eSpark-Backup/adam-lucks-gate-security-system/README.md

# AdamLucks-GateSecuritySystem
 To design and develop a Gate Security System for ZUUL systems that employs Automatic License Plate Detection and Access Control
