eSpark-Backup/adam-lucks-gate-security-system/Documents/Dev-Files/Important Links.txt

https://codrinsideas.medium.com/diy-raspberry-pi-parking-system-with-platerecognizers-alpr-8e2254298917
