eSpark-Backup/adam-lucks-gate-security-system/Documents/Dev-Files/Important Info/Bring back the CAM.docx

STEPS TO CLEAR FAULT STATE OF GOOGLE FIREBASE

1. Type VNC Viewer on search bar in windows and hit Enter.
2. The following screen will popup.

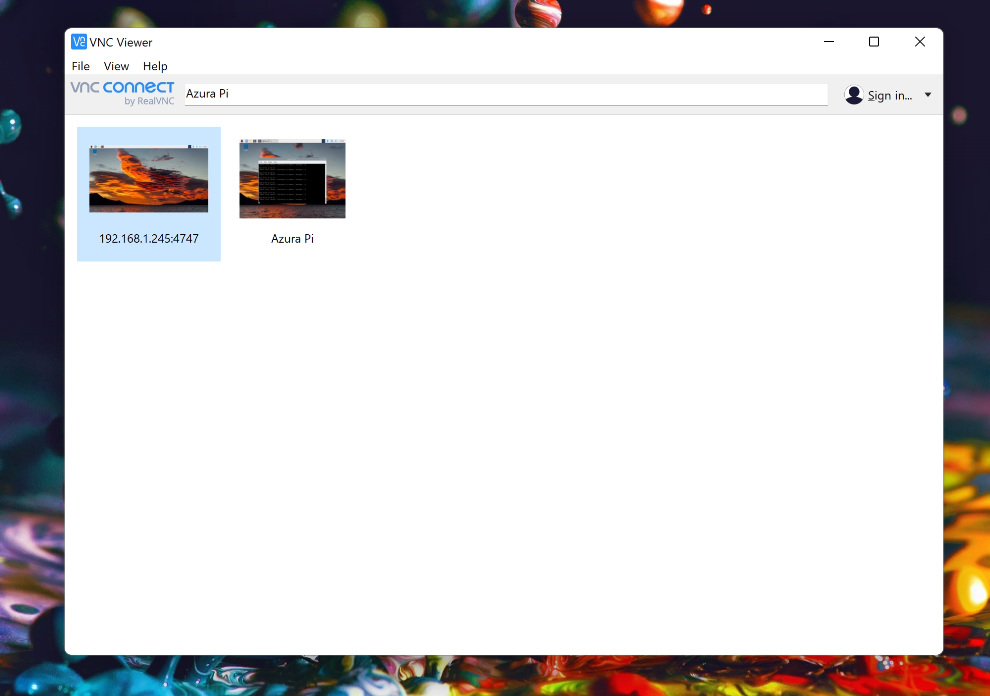
[picture p1: figure]

3. Double click on Azura Pi to remotely enter the Raspberry Pi located at Azura community
4. Click anywhere on the black window inside Azura Pi and press Ctrl+C

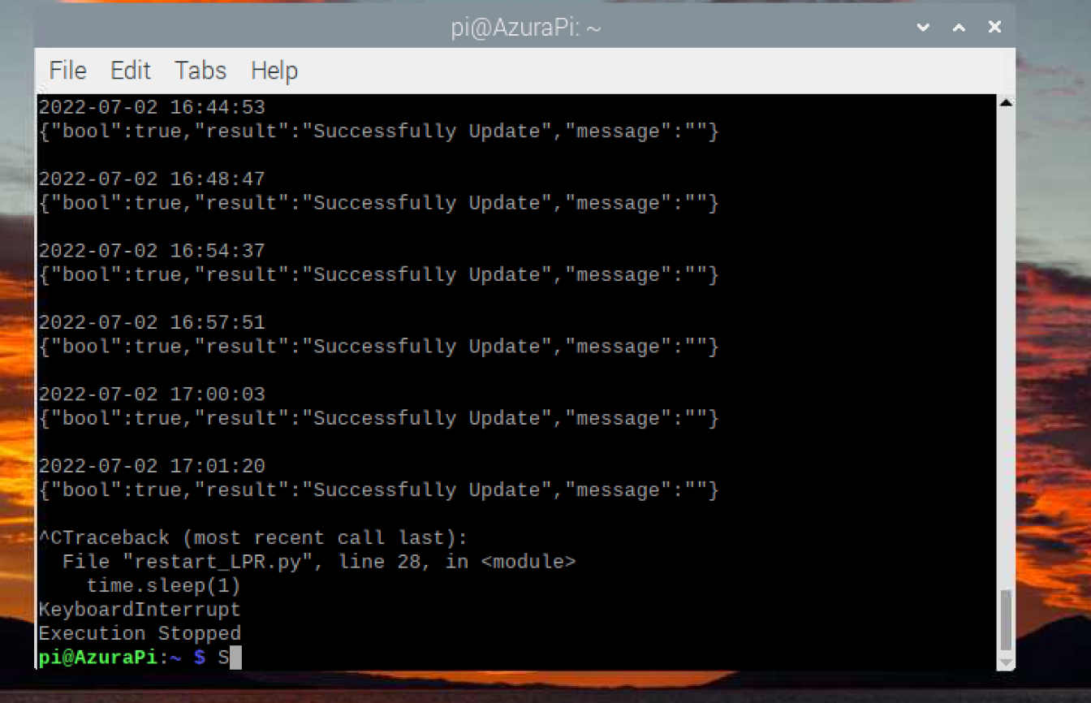
[picture p2: figure]

5. After Execution Stopped is printed on the screen, press the Upside Arrow on the keyboard or manually type in the command sudo python restart_LPR.py

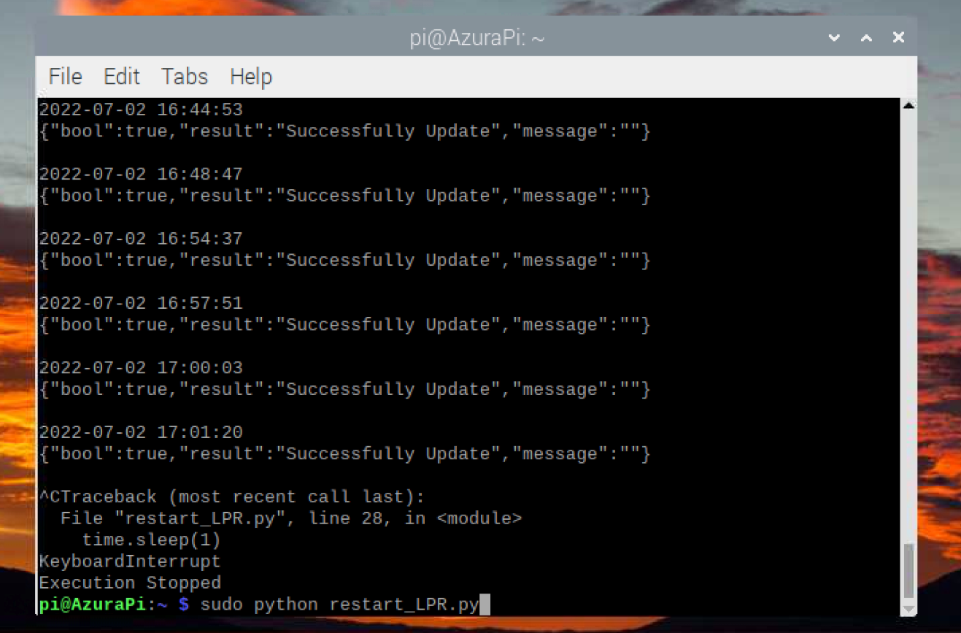
[picture p3: figure]

6. Hit Enter and retest the working of the camera. This will bring the Firebase out of hault state
