eSpark-Backup/adam-lucks-gate-security-system/Documents/Dev-Files/WebRelay Quad/readme.md

# WebRelay Quad Integration and Testing

## Useful Links
### Quick Start Guide
https://www.controlbyweb.com/webrelay-quad/webrelay-quad_qsg.pdf

### User Manual
https://www.controlbyweb.com/webrelay-quad/webrelay-quad_users_manual.pdf

### Setup Page for WebRelay Quad
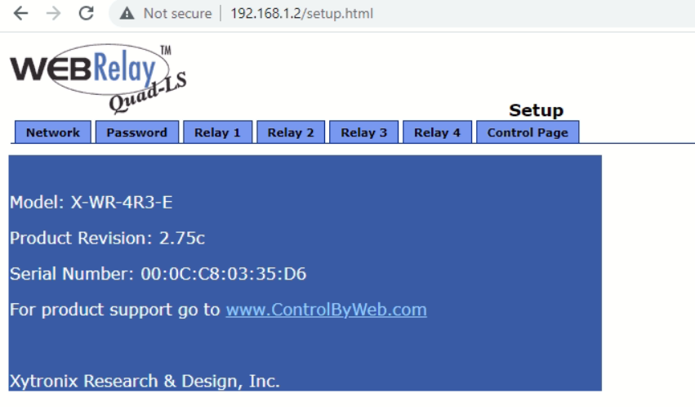
[picture p4: Documents/Dev-Files/WebRelay Quad/setup_page.png]


### WebRelay Quad Information
Setup username: admin
Setup password: zUUlSysTem
zuulsystemQuadS

Control username: admin
Control password: zUUlSysTem
