eSpark-Backup/adam-lucks-gate-security-system/Documents/Client-Files/Arduino IONO Configuration/ALL FILES/General Diagram.jpg

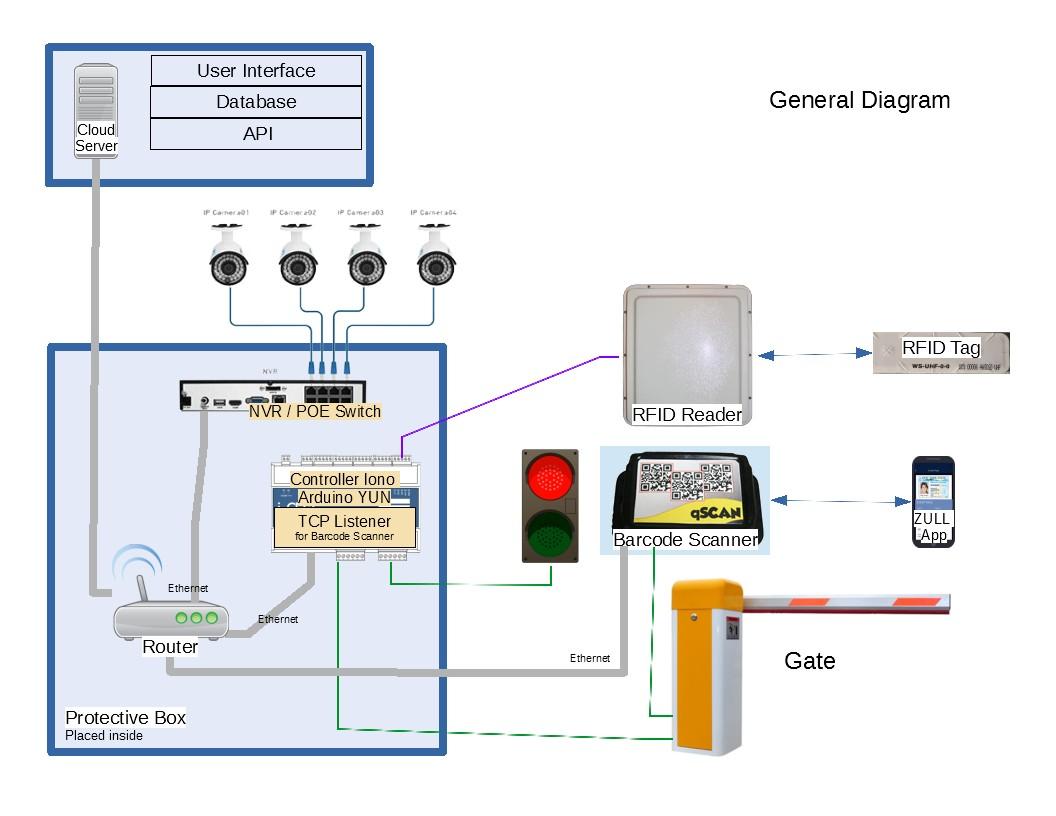
Documents/Client-Files/Arduino IONO Configuration/ALL FILES/General Diagram.jpg
