eSpark-Backup/adam-lucks-gate-security-system/Documents/Client-Files/Arduino IONO Configuration/DIAGRAMS/BLACK WHITE GREE WIRES.jpg

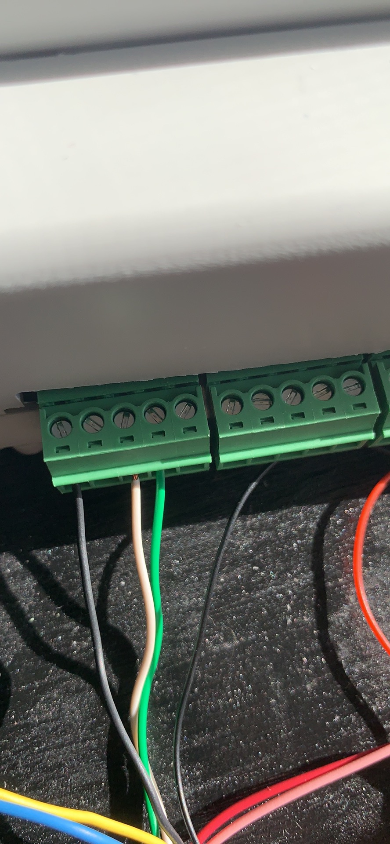
Documents/Client-Files/Arduino IONO Configuration/DIAGRAMS/BLACK WHITE GREE WIRES.jpg
