eSpark-Backup/adam-lucks-gate-security-system/Documents/Client-Files/BAI-Barcodes/Block_Diagram.png

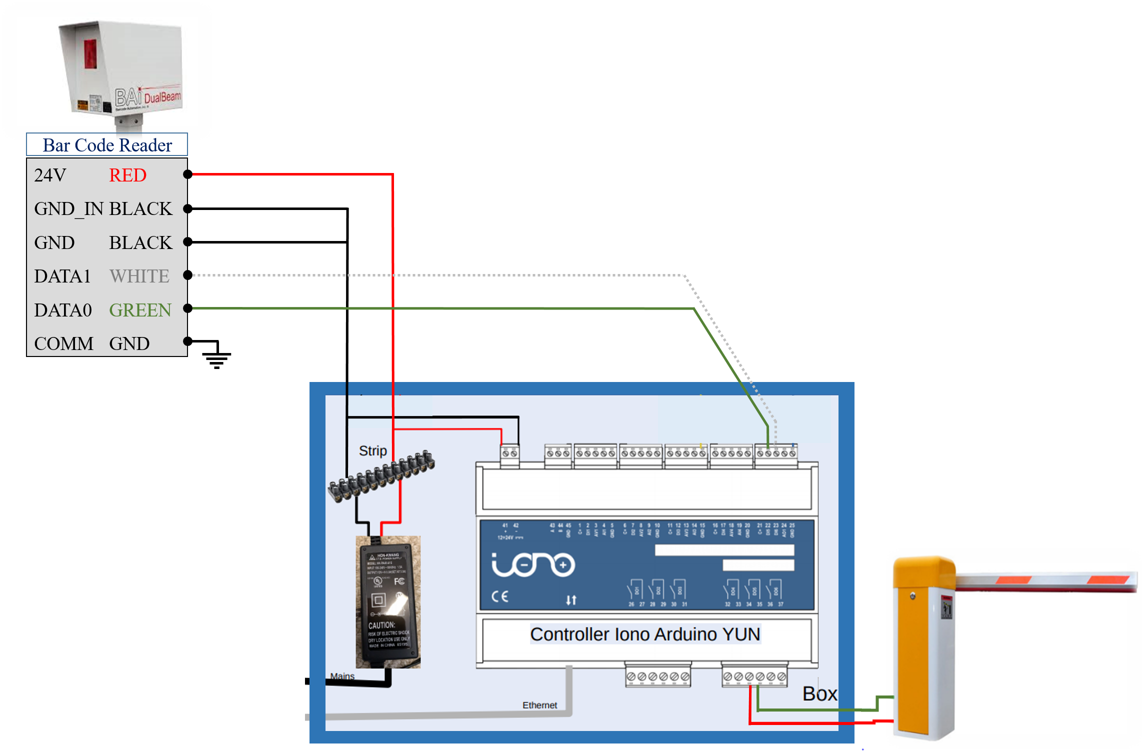
Documents/Client-Files/BAI-Barcodes/Block_Diagram.png
