eSpark-Backup/adam-lucks-gate-security-system/Documents/Client-Files/BAI-Barcodes/Firmware - BAI/docs/Maxtek Q series programmer - GOOD SETTINGS.png

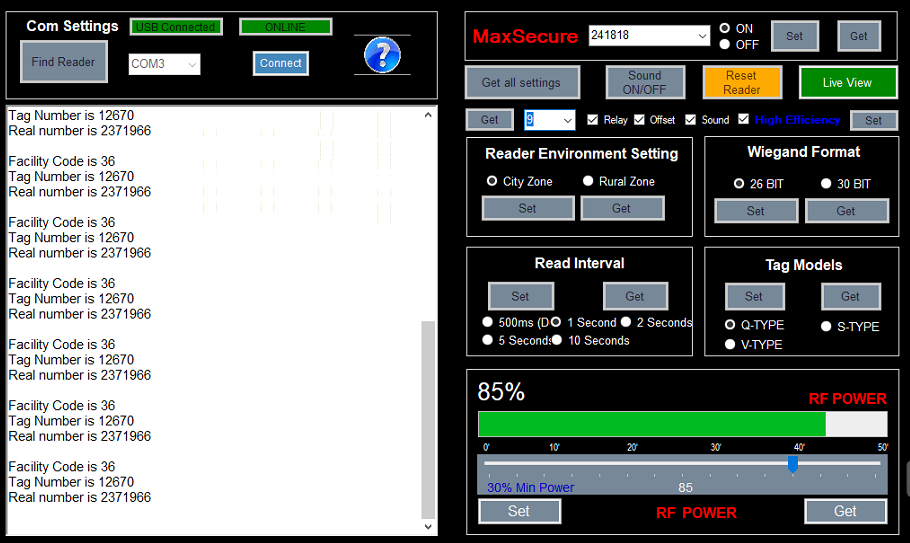
Documents/Client-Files/BAI-Barcodes/Firmware - BAI/docs/Maxtek Q series programmer - GOOD SETTINGS.png
