eSpark-Backup/adam-lucks-gate-security-system/Documents/Dev-Files/Avigilon-LPR/MockPi/1650800050.jpg

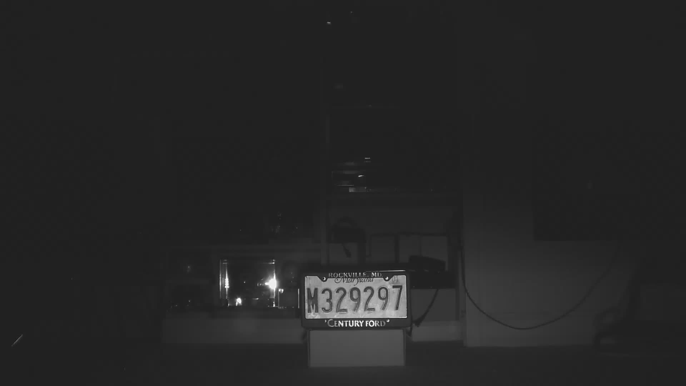
Documents/Dev-Files/Avigilon-LPR/MockPi/1650800050.jpg
