eSpark-Backup/adam-lucks-gate-security-system/Documents/Dev-Files/Avigilon-LPR/MockPi/1650800095.jpg

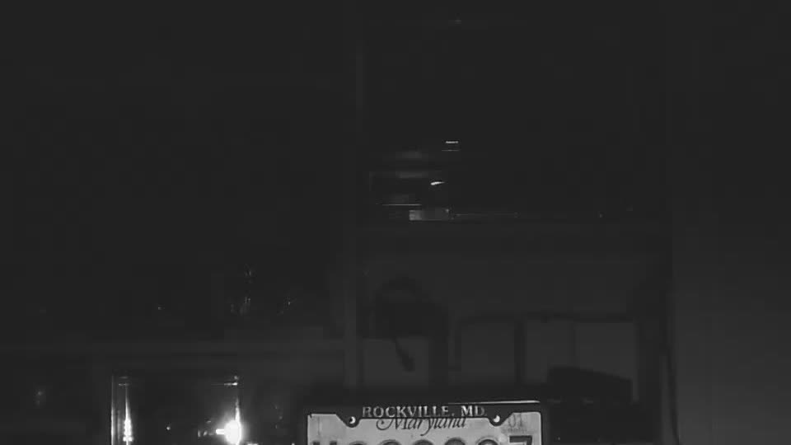
Documents/Dev-Files/Avigilon-LPR/MockPi/1650800095.jpg
