eSpark-Backup/adam-lucks-gate-security-system/Documents/Dev-Files/Avigilon-LPR/MockPi/SampleImages/capture.jpg

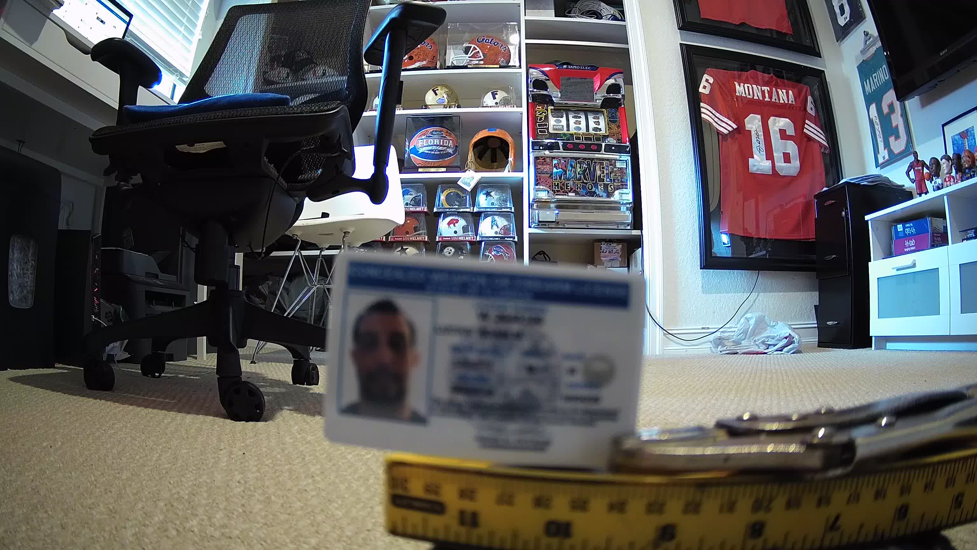
Documents/Dev-Files/Avigilon-LPR/MockPi/SampleImages/capture.jpg
