eSpark-Backup/adam-lucks-gate-security-system/Documents/Dev-Files/Avigilon-LPR/MockPi/SampleImages/image1.jpg

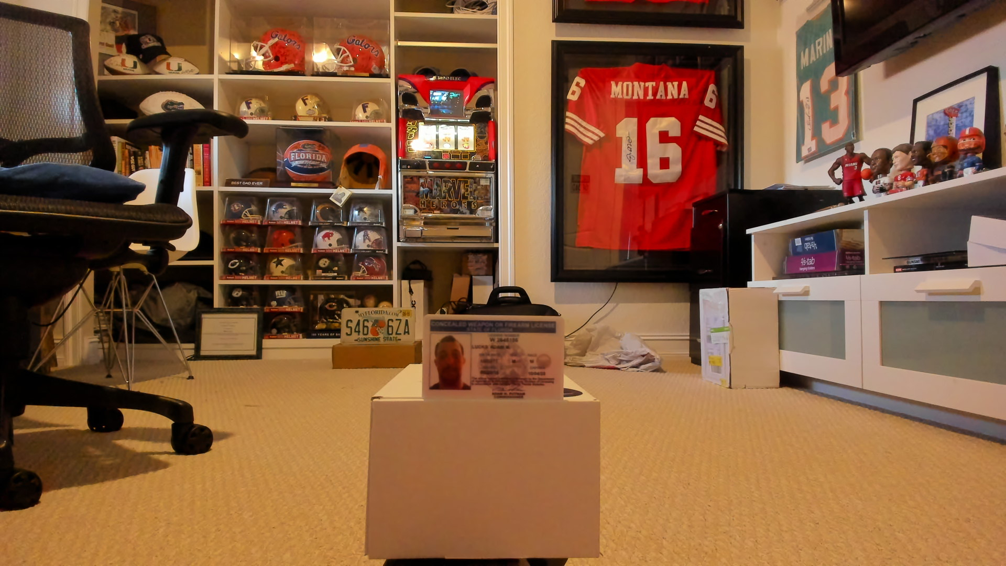
Documents/Dev-Files/Avigilon-LPR/MockPi/SampleImages/image1.jpg
