eSpark-Backup/adam-lucks-gate-security-system/Documents/Dev-Files/Raspi-ZUUL/Documents/capture.jpg

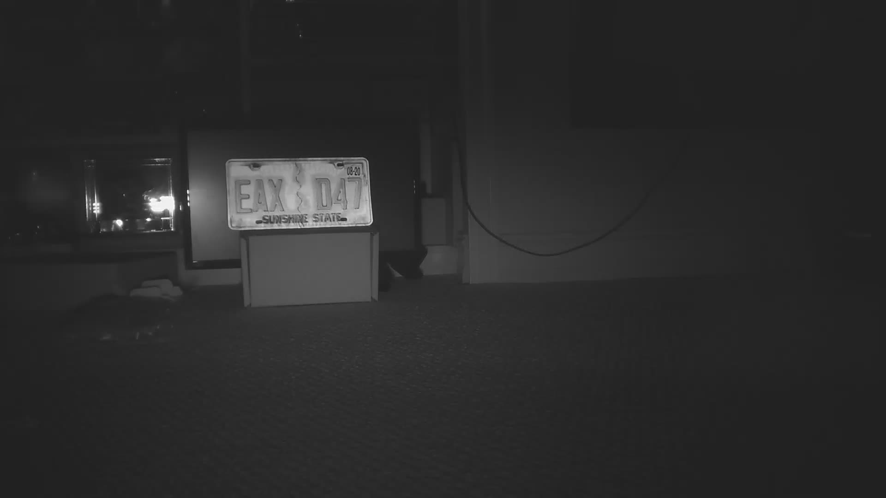
Documents/Dev-Files/Raspi-ZUUL/Documents/capture.jpg
