eSpark-Backup/adam-lucks-gate-security-system/Documents/Dev-Files/Component-Selection.xlsx

S.No | Component Name | Description | Quantity | Cost | Reference Link | Local Link | Remarks
1 | Raspberry Pi 4 Model B | RASPBERRY PI 4 MODEL B 4GB SDRAM | 1 | $90.06 | ThePiHut (https://thepihut.com/products/raspberry-pi-starter-kit?variant=30749409116222) | w11stop (https://w11stop.com/raspberry-pi-4-b-starter-kit) | 4GB version will be used and ordered by Huzaifa
2 | Camera Module | RASPBERRY PI CAMERA MODULE V2 | 1 | $25.00 | Digikey (https://www.digikey.com/en/products/detail/raspberry-pi/913-2664/6152810?src=raspberrypi) | w11stop (https://w11stop.com/raspberry-pi-camera) | Will be ordered by Huzaifa
3 | Camera Module Night | RASPBERRY PI CAMERA MODULE V2 NoIR | 1 | $25.00 | Digikey (https://www.digikey.com/en/products/detail/raspberry-pi/913-2673/6152811?src=raspberrypi) | circuit (https://circuit.pk/product/2834) | Will be ordered by Huzaifa
4 | Camera Module Day + Night | RASPBERRY PI CAMERA MODULE AUTOMATIC IR CUT | 1 | $27.99 | UCTRONICS (https://www.uctronics.com/arducam-for-raspberry-pi-noir-5mp-ov5647-camera-module-motorized-ir-cut-filter-for-daylight-and-night-vision-2239.html) | - | Will be ordered by Sir Hassan internationally. Link provided
5 | LaserJet Printer | HP LASERJET PRINTER FOR AIRPRINT | 1 | $299.00 | HP (https://www.hp.com/sg-en/shop/printers/personal-and-home-printers/laserjet/hp-color-laser-150nw-4zb95a.html) | - | Any printer can be used provided it has a USB or an ethernet or WiFi interface
