eSpark-Backup/adam-lucks-gate-security-system/Documents/Dev-Files/Avigilon-LPR/test1.jpg

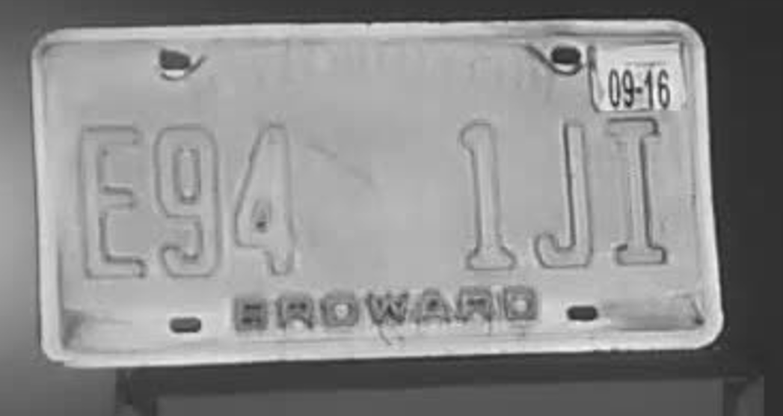
Documents/Dev-Files/Avigilon-LPR/test1.jpg
