eSpark-Backup/adam-lucks-gate-security-system/Documents/Dev-Files/Avigilon-LPR/test.jpg

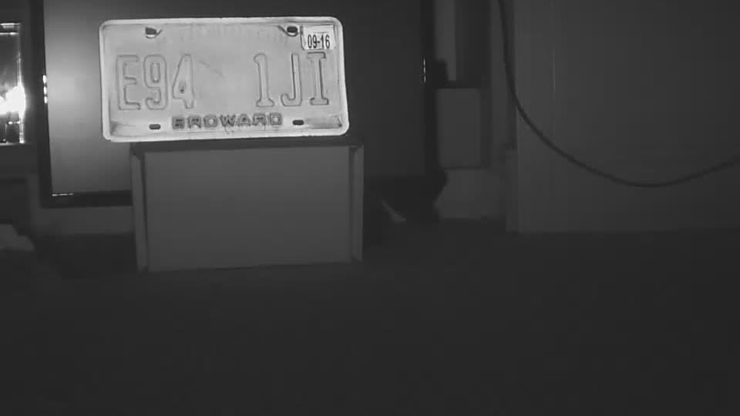
Documents/Dev-Files/Avigilon-LPR/test.jpg
