eSpark-Backup/adam-lucks-gate-security-system/Documents/Dev-Files/Raspi-ZUUL/Test-Images/car_03112021.jpg

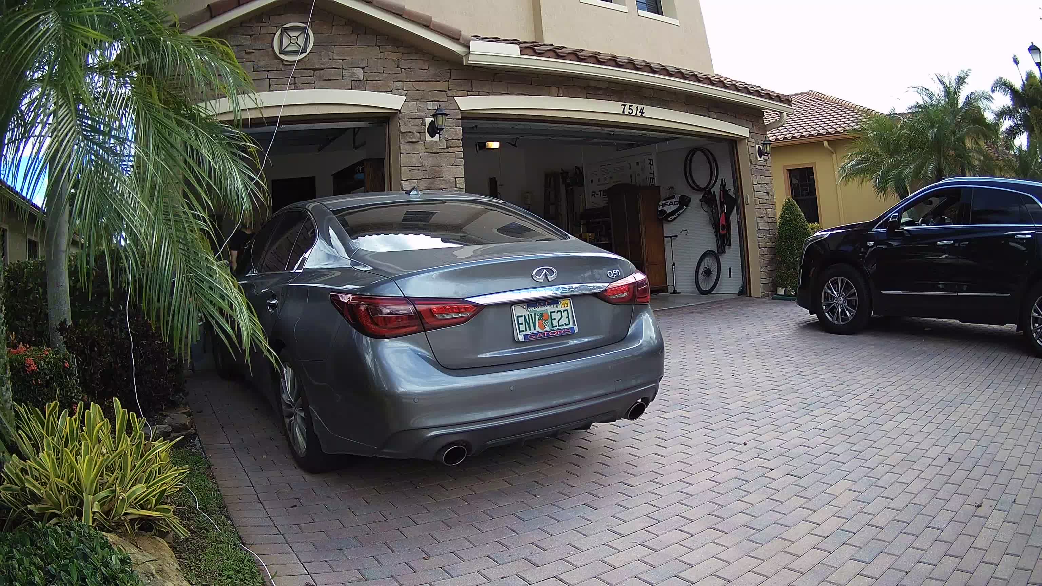
Documents/Dev-Files/Raspi-ZUUL/Test-Images/car_03112021.jpg
