eSpark-Backup/adam-lucks-gate-security-system/Documents/Dev-Files/Raspi-ZUUL/Test-Images/car_03112021_3.jpg

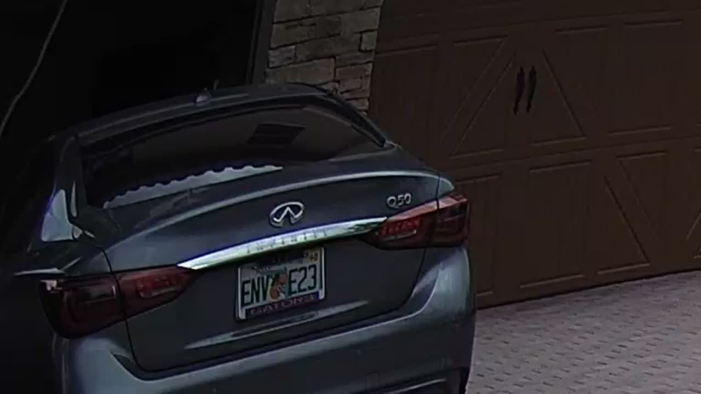
Documents/Dev-Files/Raspi-ZUUL/Test-Images/car_03112021_3.jpg
