eSpark-Backup/adam-lucks-gate-security-system/Documents/Dev-Files/Raspi-ZUUL/Test-Images/car_18112021_1.jpg

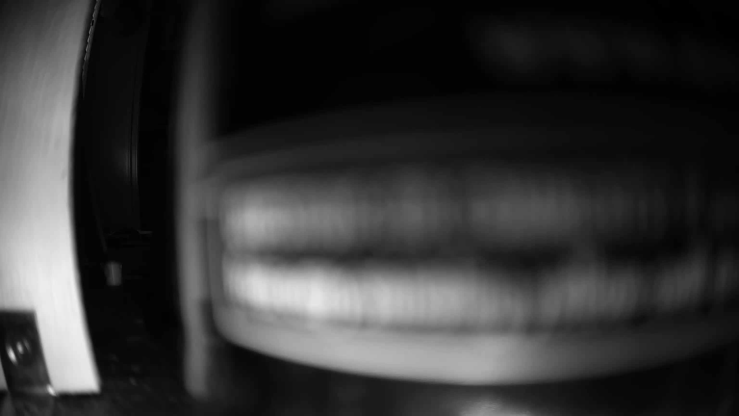
Documents/Dev-Files/Raspi-ZUUL/Test-Images/car_18112021_1.jpg
