eSpark-Backup/adam-lucks-gate-security-system/Documents/Dev-Files/Raspi-ZUUL/Test-Images/car_lic2.jpg

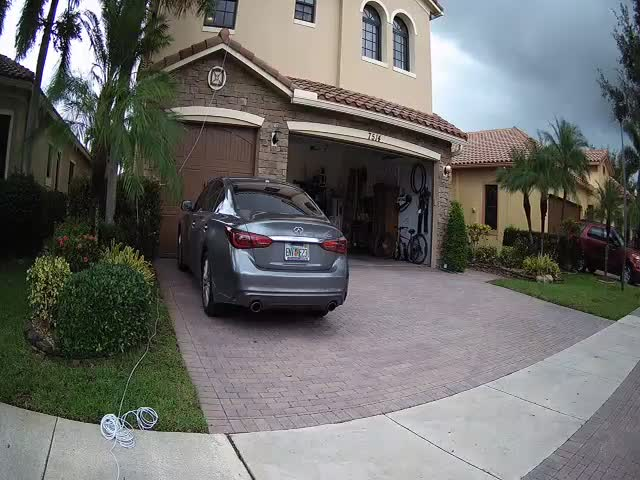
Documents/Dev-Files/Raspi-ZUUL/Test-Images/car_lic2.jpg
