eSpark-Backup/adam-lucks-gate-security-system/Documents/Dev-Files/Raspi-ZUUL/Test-Images/licence.jpg

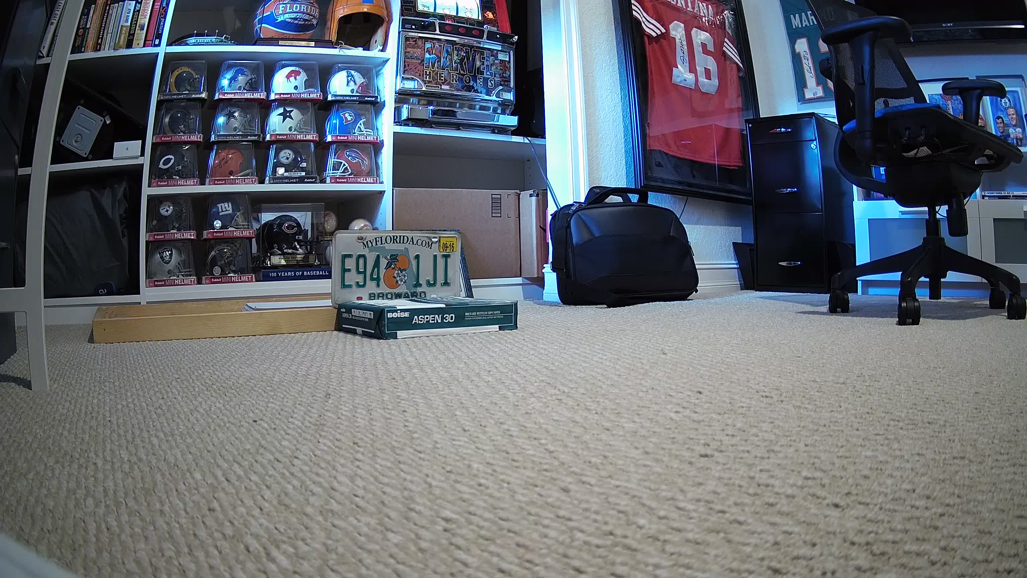
Documents/Dev-Files/Raspi-ZUUL/Test-Images/licence.jpg
