eSpark-Backup/adam-lucks-gate-security-system/Documents/Dev-Files/Raspi-ZUUL/Test-Images/new_test.jpg

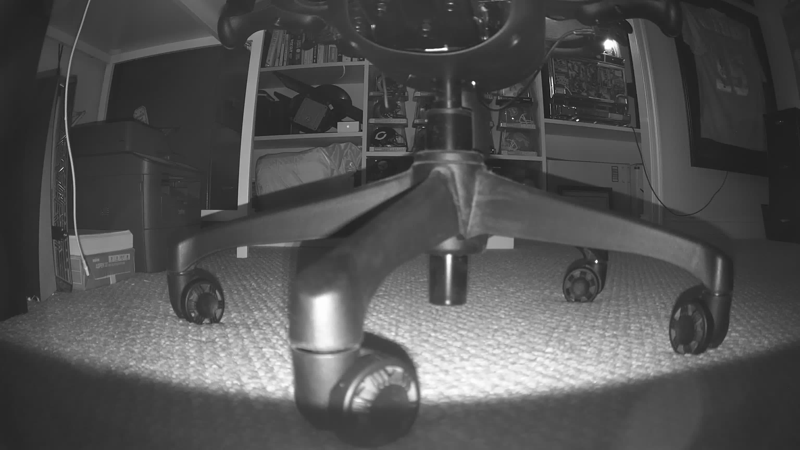
Documents/Dev-Files/Raspi-ZUUL/Test-Images/new_test.jpg
