eSpark-Backup/adam-lucks-gate-security-system/Documents/Dev-Files/Raspi-ZUUL/Test-Images/OCR_Image.jpg

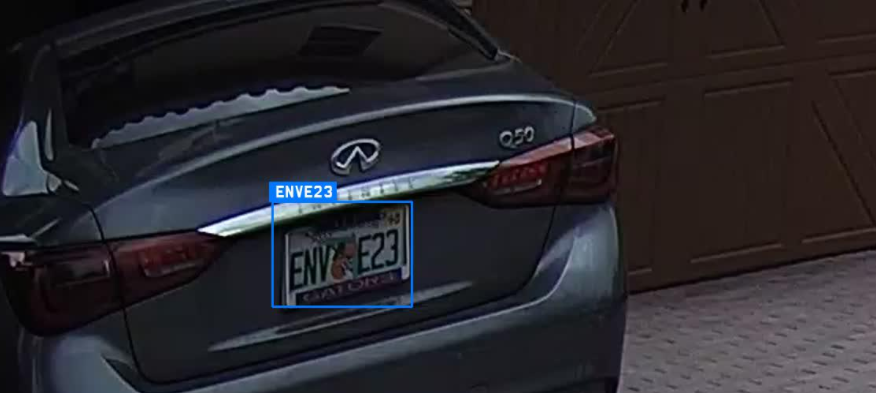
Documents/Dev-Files/Raspi-ZUUL/Test-Images/OCR_Image.jpg
