eSpark-Backup/adam-lucks-gate-security-system/Documents/Client-Files/Arduino IONO Configuration/CODE FILES/Controller with RFID Reader/Simple Wiring Diagram.pdf

# Awid LR-2000

# Simple Wiring Diagram

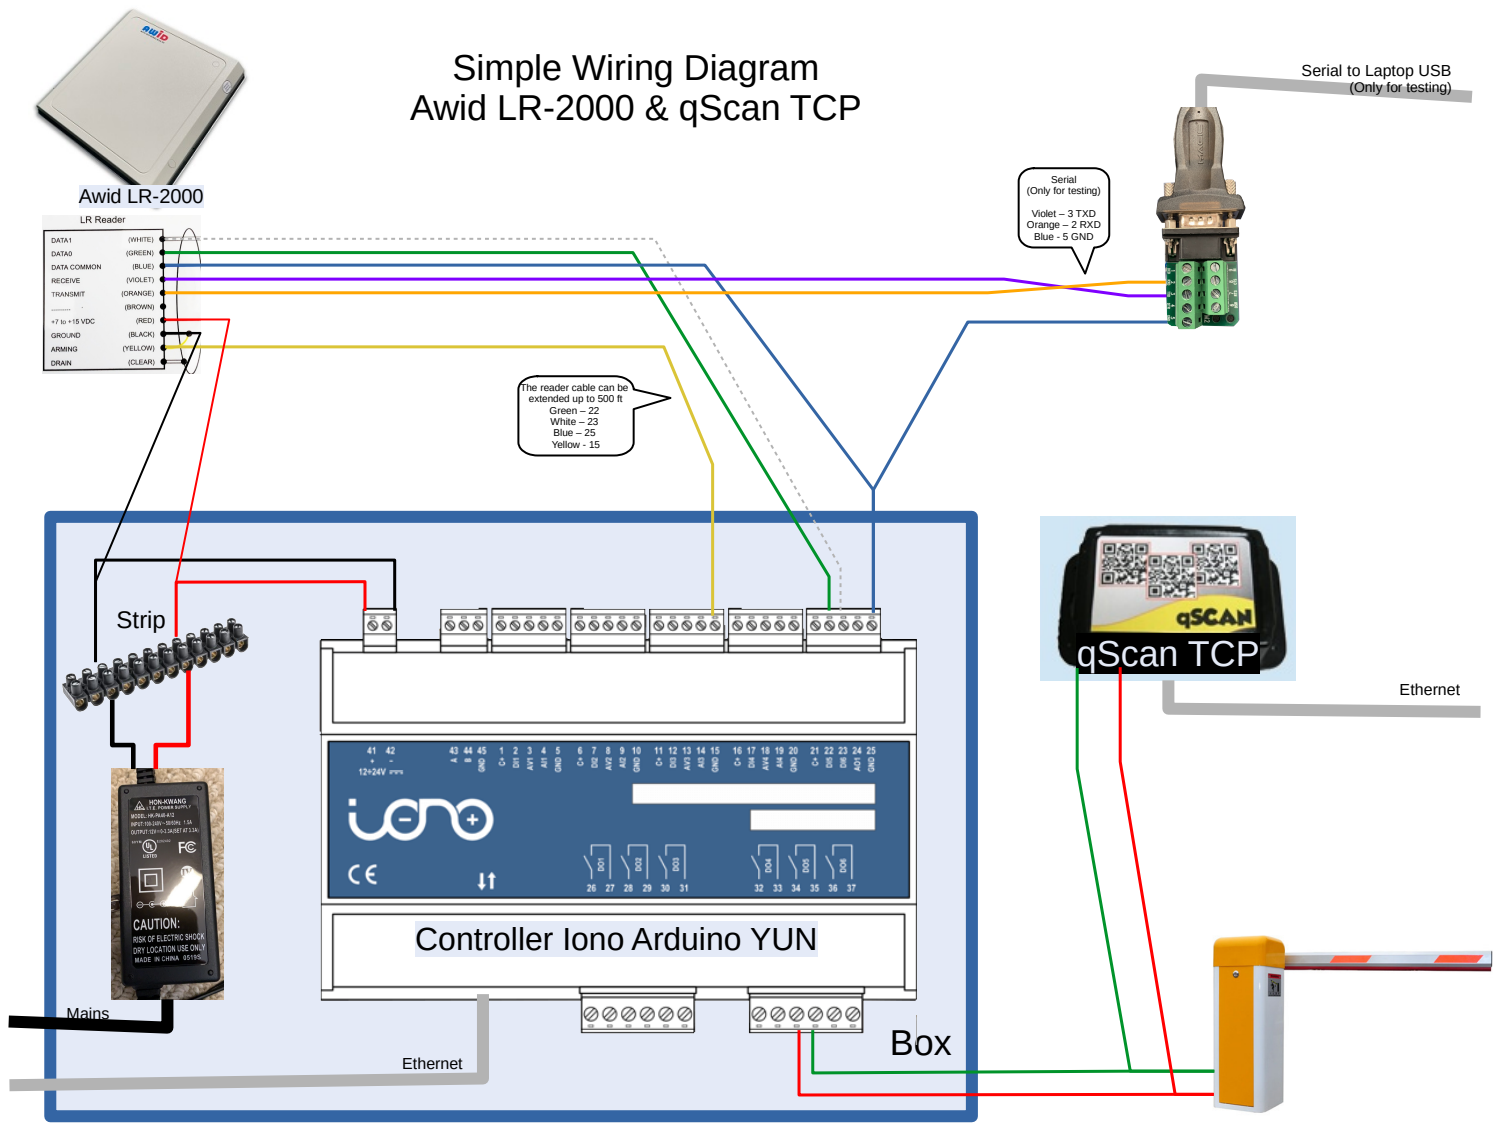
[picture p29: page 1]
Box; Strip; Mains; qScan TCP; Ethernet; Violet – 3 TXD Orange – 2 RXD Blue - 5 GND

Serial to Laptop USB
(Only for testing)

Awid LR-2000 & qScan TCP

Serial

The reader cable can be
extended up to 500 ft
Green – 22
White – 23
Blue – 25
Yellow - 15

Controller Iono Arduino YUN

# QScan serial

# Simple Wiring Diagram

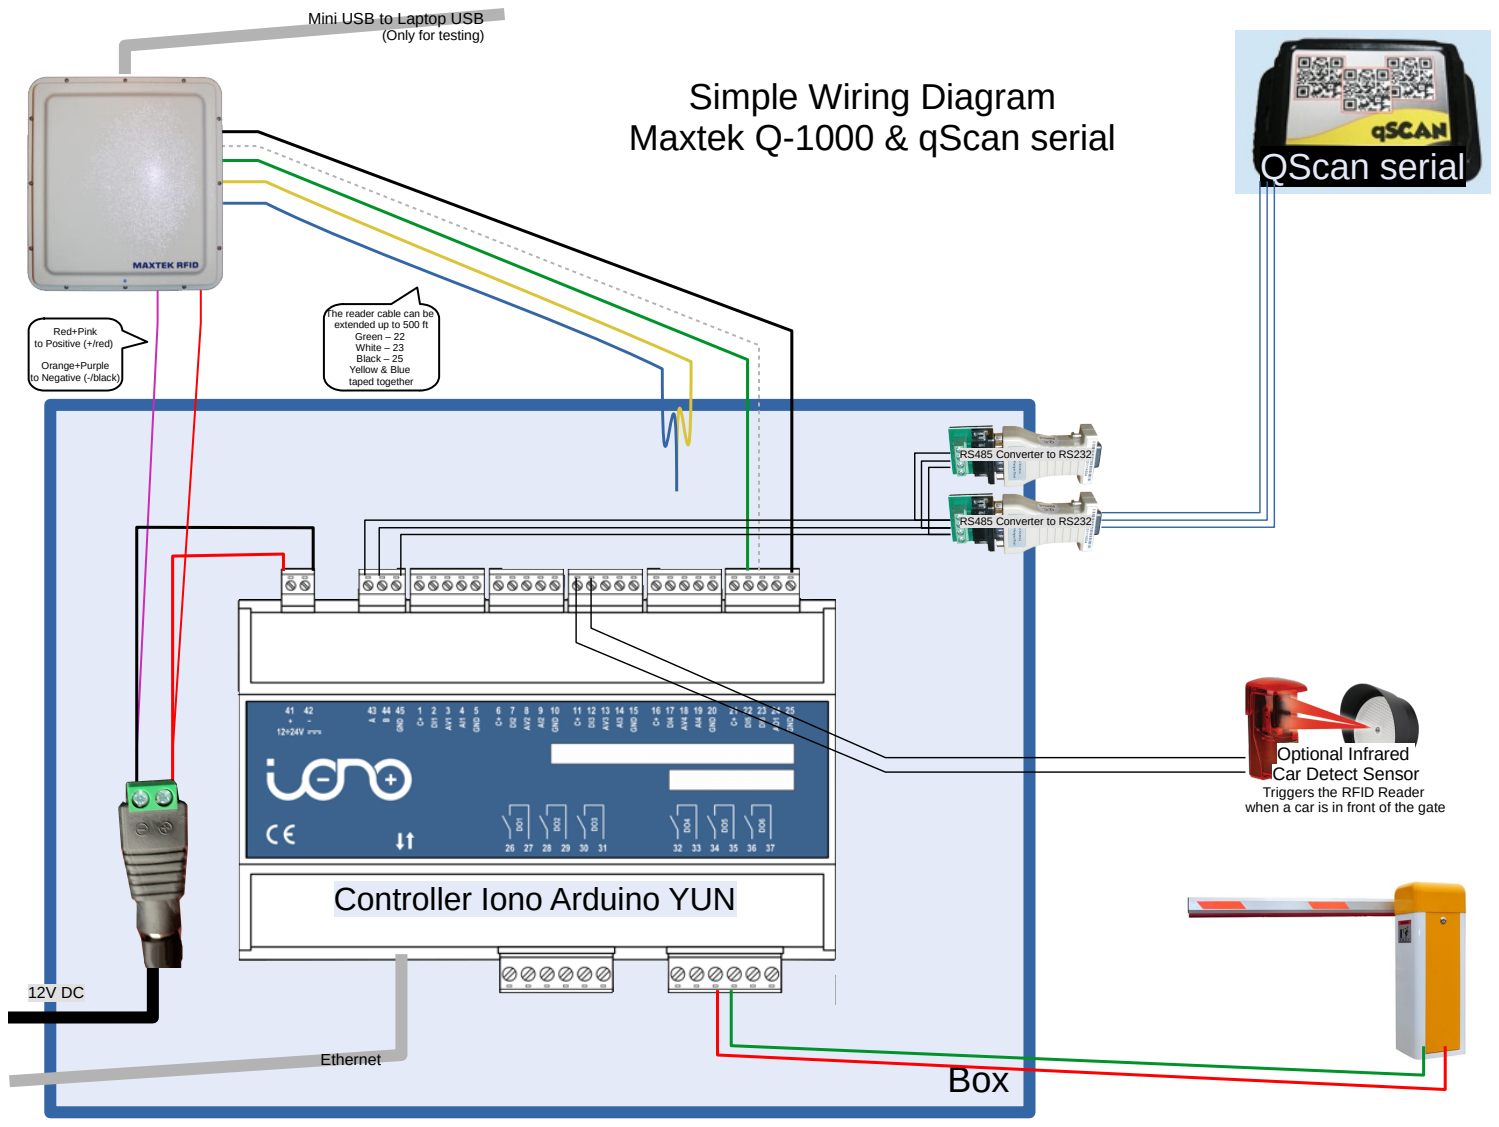
[picture p30: page 2]
Box; Ethernet; RS485 Converter to RS232

Mini USB to Laptop USB

(Only for testing)

Maxtek Q-1000 & qScan serial

The reader cable can be
extended up to 500 ft
Green – 22
White – 23
Black – 25
Yellow & Blue
taped together

Red+Pink
to Positive (+/red)

Orange+Purple
to Negative (-/black)

Optional Infrared
Car Detect Sensor
Triggers the RFID Reader
when a car is in front of the gate

Controller Iono Arduino YUN
