eSpark-Backup/adam-lucks-gate-security-system/(commit log)

2021-08-03 Wiring Text File Updated
2021-08-16 Camera Streaming Information
2021-08-17 Capture camera frame using FFMPEG
2021-08-19 Camera Frame Capture Algorithm Refined
2021-09-08 Platerecognizer API Testing
2021-09-16 License Plate Outside Test
2021-11-03 OCR Correction and Camera Zoom In
2021-11-06 Fan link included in parts document
2021-11-27 Printer Drivers for Airprint
2021-11-28 Airprint Printer Driver Generic
2021-11-28 Linux Driver Distribution for Brother Printer
2021-12-11 OCR test on multiple plates(unsuccessful)
2022-01-05 Uploaded Fixed Mounted Scanner Instructions
2022-03-20 Added cameraMAC in Alibi Camera script
2022-03-26 Added Pi login info; changed plateNum to "0"
2022-04-13 PB Pi Camera successful testing
2022-04-13 Added empty plate_num for manual entry
2022-04-24 Webhook platenum testing; LPR script modified success
2022-05-24 PB UID added in script; Adam Office switched to ZUUL master DB
2022-05-27 Testing camera and firebase webhooks
2022-06-02 RFID SYNC "already received" timer changed to 1 sec
2022-06-23 Logitech camera tested
2022-08-05 readme for Quad Relay updated
2022-08-05 relay settings image added
2022-08-05 Added username and password for Relay
2022-08-21 WebRelay and Camera sequence merged (zuul2 Mockpi)
2022-08-22 Mockpi cam switched to Live
2022-09-14 Relay Chatter Testing
